ni-c/eve/documents/img/stepdown5v.jpg

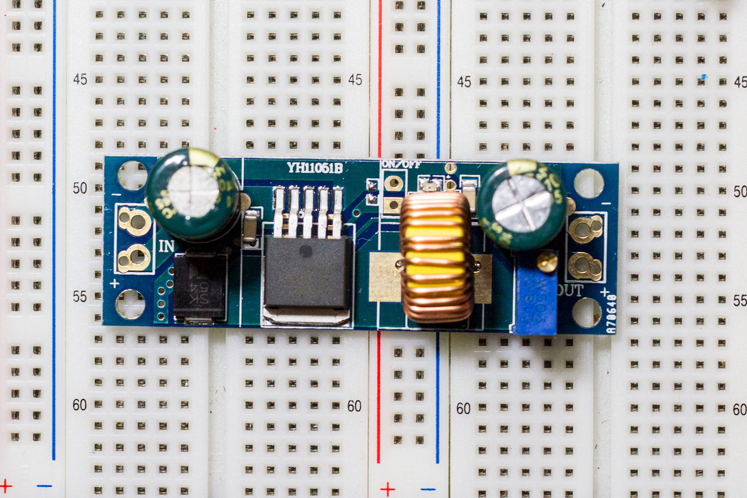
documents/img/stepdown5v.jpg
