ni-c/eve/documents/img/stepper.jpg

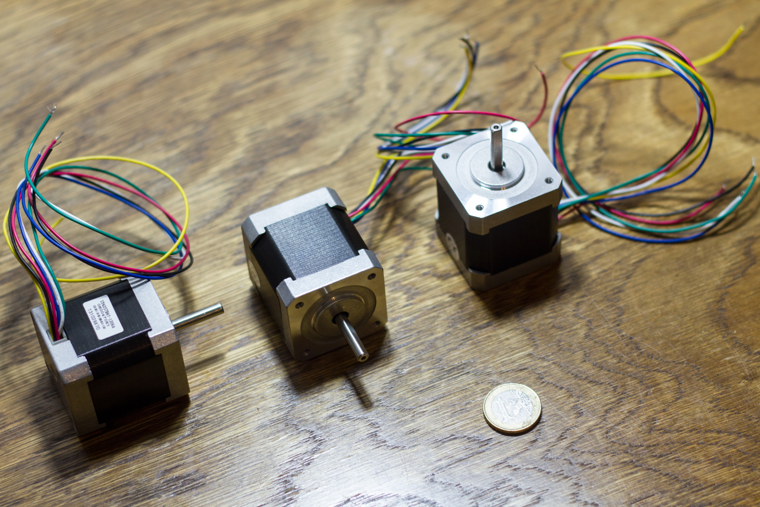
documents/img/stepper.jpg
