ni-c/eve/README.md

# eve

in action: https://vine.co/v/OreTuQMjX1V

### Autonomous omniwheel robot

Coded, compiled and flashed with a Raspberry PI

![eve] (https://raw.githubusercontent.com/ni-c/eve/master/documents/img/eve.001.jpg)

## Baseboard

### WIP

![Baseboard Schematics] (https://raw.githubusercontent.com/ni-c/eve/master/documents/img/baseboard.png)
