ni-c/eve/documents/img/baseboard.png

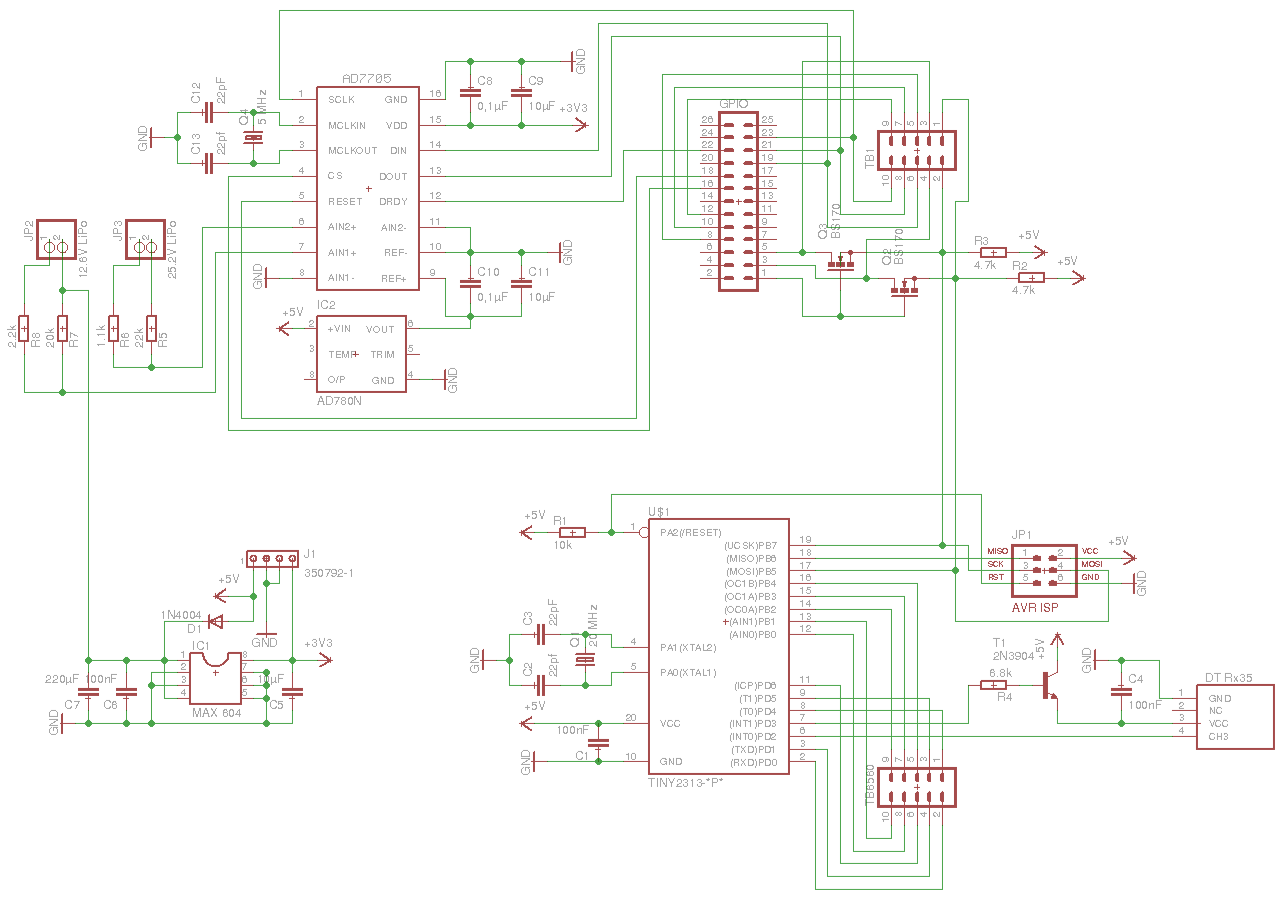
documents/img/baseboard.png
