ni-c/eve/documents/img/baseboard_bb.png

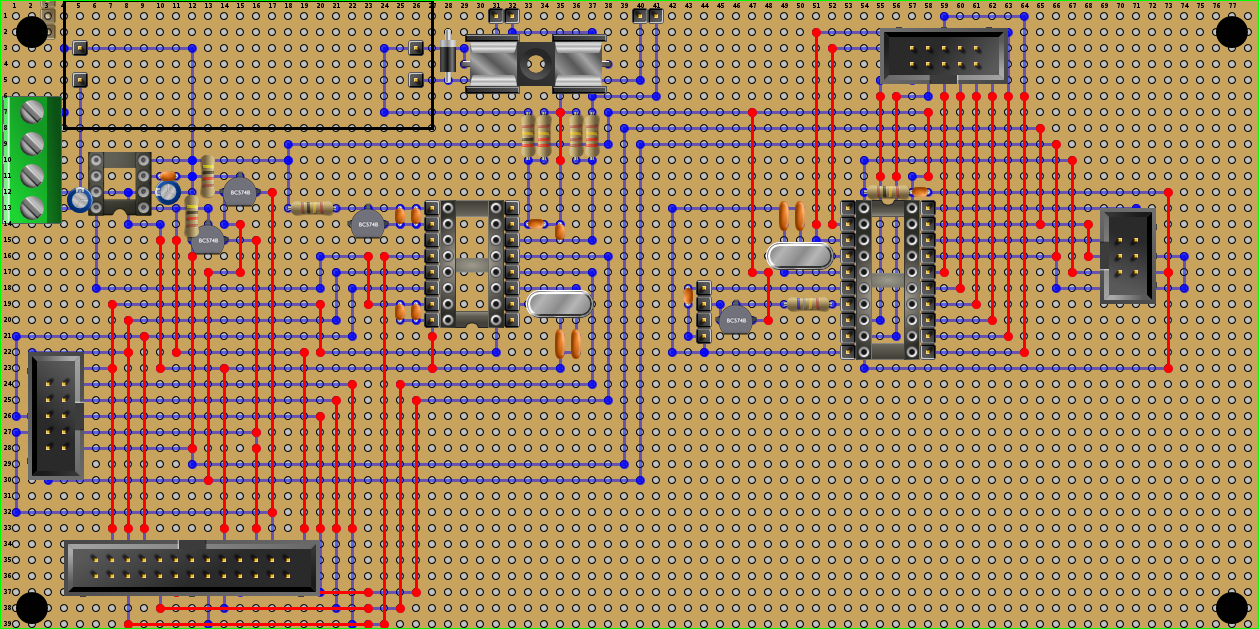
documents/img/baseboard_bb.png
