ni-c/eve/documents/img/baseboard_bb_back.png

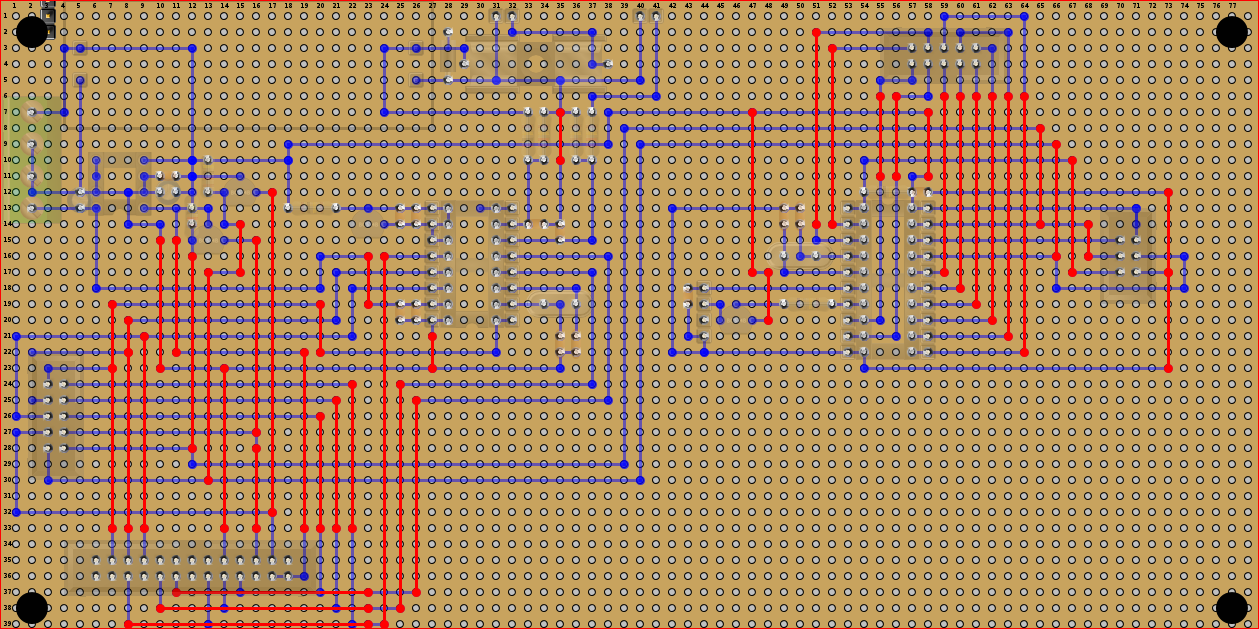
documents/img/baseboard_bb_back.png
