ni-c/eve/documents/img/eve.001.jpg

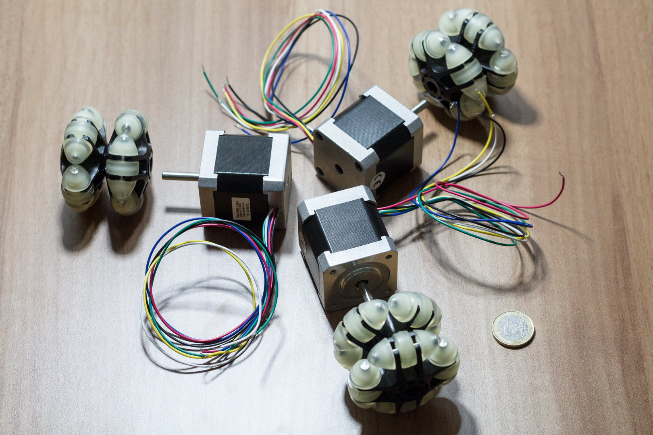
documents/img/eve.001.jpg
