ni-c/eve/documents/img/omniwheels.jpg

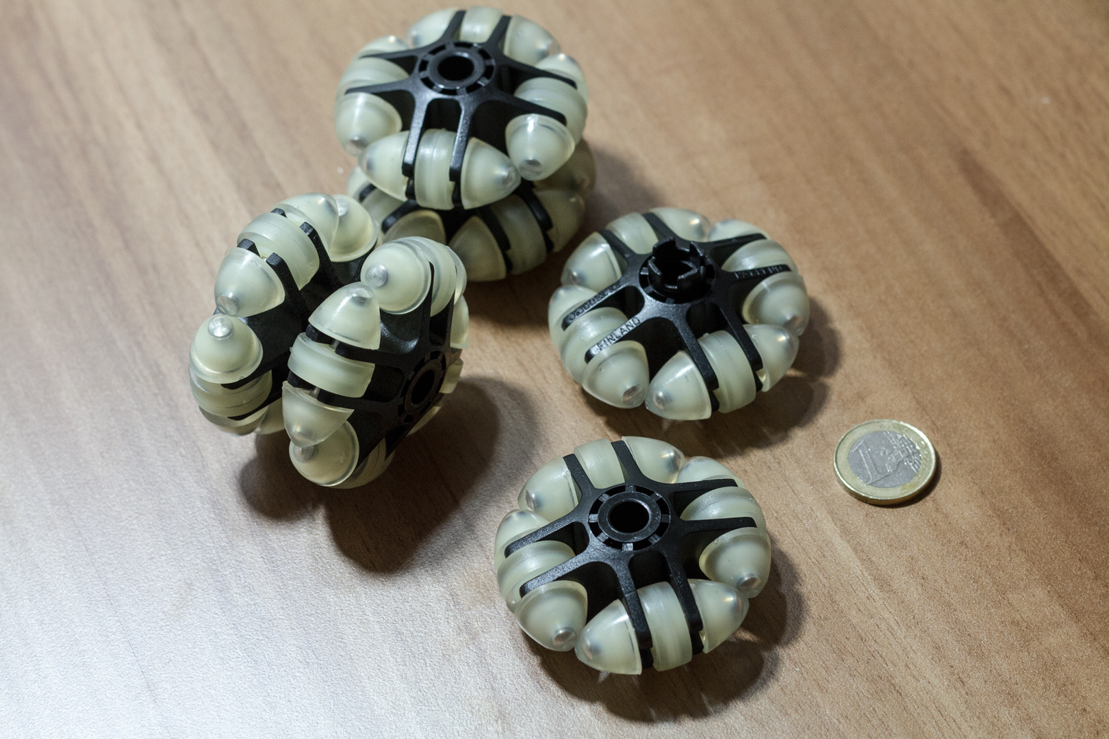
documents/img/omniwheels.jpg
