ni-c/eve/pi/client/img/motors.png

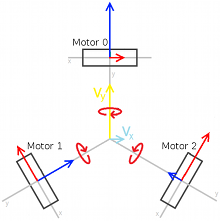
pi/client/img/motors.png
