ni-c/eve/documents/schematics/baseboard.sch

## EAGLE design documents/schematics/baseboard.sch (2014-02-16)

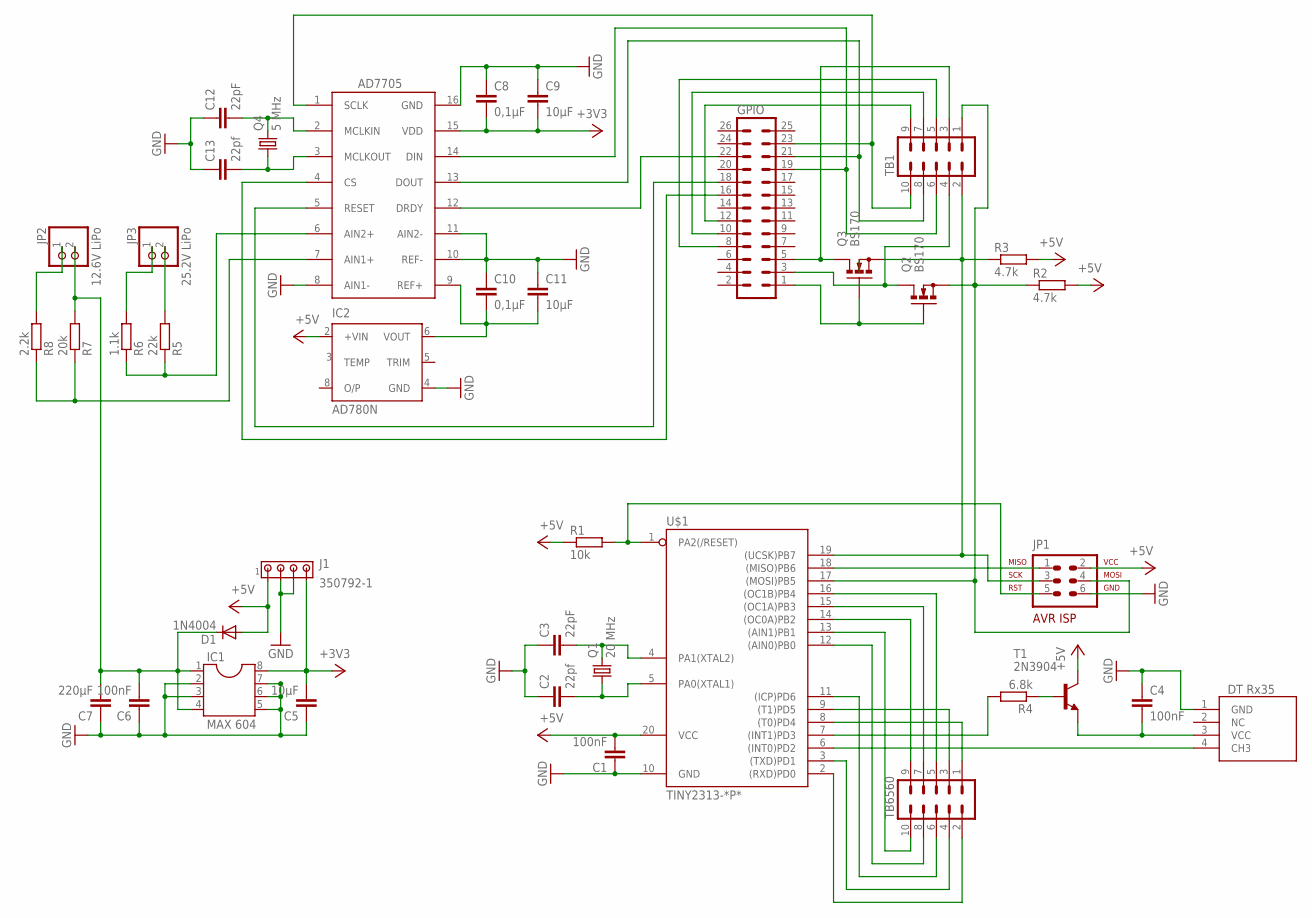
[picture p9: schematic baseboard.sch]

Parts:
C1, C4, C6: 100nF; C2.5-2
C2, C13: 22pf; C2.5-2
C3, C12: 22pF; C2.5-2
C5, C9, C11: 10µF; C2.5-2
C7: 220µF; C2.5-2
C8, C10: 0,1µF; C2.5-2
D1: 1N4004; DO41-10
GPIO: ML26
IC1: MAX 604; DIL08
IC2: AD780N; DIL08
J1: 350792-1
JP1: AVR-ISP-6VERT; AVR-ISP-6
JP2: 12.6V LiPo; 1X02
JP3: 25.2V LiPo; 1X02
Q1: 20 MHz; HC49/S
Q2, Q3: BS170; SOT54E
Q4: 5 MHz; HC49/S
R1: 10k; 0207/2V
R2, R3: 4.7k; 0207/2V
R4: 6.8k; 0207/12
R5: 22k; 0207/2V
R6: 1.1k; 0207/2V
R7: 20k; 0207/2V
R8: 2.2k; 0207/2V
T1: 2N3904; TO92
TB1, TB6560: ML10
U$1: TINY2313-*P*; DIL20
U$2: DTRX35
U$3: AD7705; AD7705BNC

Connections:
+3V3: C5.2, C8.2, C9.2, IC1.8, J1.4, U$3.15 (VDD)
+5V: C1.2, D1.A, IC2.2 (+VIN), J1.1, JP1.2, R1.1, R2.2, R3.2, T1.1 (C), U$1.20 (VCC)
GND: C1.1, C2.1, C3.1, C4.1, C5.1, C6.1, C7.1, C8.1, C9.1, C10.1, C11.1, C12.1, C13.1, IC1.2, IC1.3, IC1.5, IC1.6, IC1.7, IC2.4 (GND), J1.2, J1.3, JP1.6, U$1.10 (GND), U$2.1 (GND), U$3.8 (AIN1-), U$3.10 (REF-), U$3.11 (AIN2-), U$3.16 (GND)
unnamed: JP1.1, U$1.18 ((MISO)PB6)
unnamed: GPIO.5, Q3.D, TB1.3
unnamed: GPIO.3, Q2.D, TB1.4
unnamed: GPIO.1, Q2.G, Q3.G
unnamed: TB6560.1, U$1.8 ((T0)PD4)
unnamed: TB6560.3, U$1.9 ((T1)PD5)
unnamed: TB6560.5, U$1.16 ((OC1B)PB4)
unnamed: TB6560.7, U$1.15 ((OC1A)PB3)
unnamed: TB6560.9, U$1.14 ((OC0A)PB2)
unnamed: TB6560.10, U$1.13 ((AIN1)PB1)
unnamed: TB6560.8, U$1.12 ((AIN0)PB0)
unnamed: TB6560.6, U$1.11 ((ICP)PD6)
unnamed: TB6560.4, U$1.3 ((TXD)PD1)
unnamed: R4.1, T1.2 (B)
unnamed: JP1.4, Q2.S, R2.1, TB1.1, U$1.17 ((MOSI)PB5)
unnamed: C4.2, T1.3 (E), U$2.3 (VCC)
unnamed: R4.2, U$1.7 ((INT1)PD3)
unnamed: C3.2, Q1.2, U$1.4 (PA1(XTAL2))
unnamed: C2.2, Q1.1, U$1.5 (PA0(XTAL1))
unnamed: JP1.5, R1.2, U$1.1 (PA2(/RESET))
unnamed: U$1.6 ((INT0)PD2), U$2.4 (CH3)
unnamed: TB6560.2, U$1.2 ((RXD)PD0)
unnamed: GPIO.12, TB1.9
unnamed: GPIO.10, TB1.7
unnamed: GPIO.8, TB1.5
unnamed: GPIO.23, TB1.10, U$3.1 (SCLK)
unnamed: JP1.3, Q3.S, R3.1, TB1.2, U$1.19 ((UCSK)PB7)
unnamed: GPIO.21, TB1.8, U$3.13 (DOUT)
unnamed: GPIO.19, TB1.6, U$3.14 (DIN)
unnamed: C10.2, C11.2, IC2.6 (VOUT), U$3.9 (REF+)
unnamed: C6.2, C7.2, D1.C, IC1.1, IC1.4, JP2.2, R7.2
unnamed: JP3.1, R6.2
unnamed: JP2.1, R8.2
unnamed: C12.2, Q4.2, U$3.2 (MCLKIN)
unnamed: C13.2, Q4.1, U$3.3 (MCLKOUT)
unnamed: R5.1, R6.1, U$3.6 (AIN2+)
unnamed: R7.1, R8.1, U$3.7 (AIN1+)
unnamed: JP3.2, R5.2
unnamed: GPIO.22, U$3.12 (DRDY)
unnamed: GPIO.16, U$3.4 (CS)
unnamed: GPIO.18, U$3.5 (RESET)
