ni-c/eve/documents/schematics/tiny2313.sch

## EAGLE design documents/schematics/tiny2313.sch (2014-01-26)

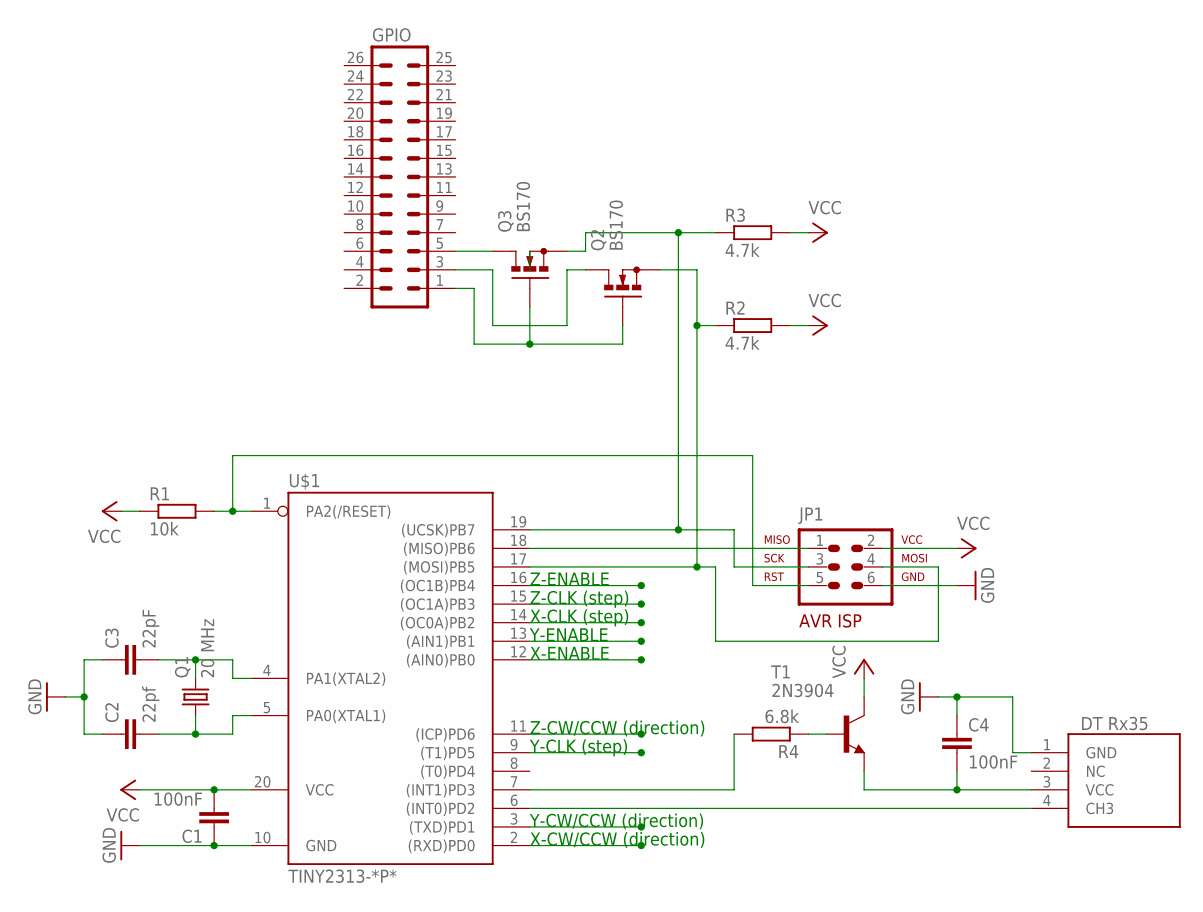
[picture p10: schematic tiny2313.sch]

Parts:
C1, C4: 100nF; C2.5-2
C2: 22pf; C2.5-2
C3: 22pF; C2.5-2
GPIO: ML26
JP1: AVR-ISP-6VERT; AVR-ISP-6
Q1: 20 MHz; HC49/S
Q2, Q3: BS170; SOT54E
R1: 10k; 0207/2V
R2, R3: 4.7k; 0207/2V
R4: 6.8k; 0207/12
T1: 2N3904; TO92
U$1: TINY2313-*P*; DIL20
U$2: DTRX35

Connections:
GND: C1.1, C2.1, C3.1, C4.1, JP1.6, U$1.10 (GND), U$2.1 (GND)
unnamed: JP1.1, U$1.18 ((MISO)PB6)
unnamed: GPIO.5, Q3.D
unnamed: GPIO.3, Q2.D
unnamed: GPIO.1, Q2.G, Q3.G
unnamed: R4.1, T1.2 (B)
unnamed: JP1.4, Q2.S, R2.1, U$1.17 ((MOSI)PB5)
unnamed: C4.2, T1.3 (E), U$2.3 (VCC)
unnamed: R4.2, U$1.7 ((INT1)PD3)
unnamed: C3.2, Q1.2, U$1.4 (PA1(XTAL2))
unnamed: C2.2, Q1.1, U$1.5 (PA0(XTAL1))
unnamed: JP1.5, R1.2, U$1.1 (PA2(/RESET))
unnamed: U$1.6 ((INT0)PD2), U$2.4 (CH3)
unnamed: JP1.3, Q3.S, R3.1, U$1.19 ((UCSK)PB7)
VCC: C1.2, JP1.2, R1.1, R2.2, R3.2, T1.1 (C), U$1.20 (VCC)

Notes on the sheet:
X-CLK (step)
Y-CLK (step)
Z-CLK (step)
X-ENABLE
Y-ENABLE
Z-ENABLE
X-CW/CCW (direction)
Y-CW/CCW (direction)
Z-CW/CCW (direction)
