ni-c/eve/baseboard/include/i2cslave.h

/*
 *
 * Name: USI TWI Slave driver - I2C/TWI-EEPROM
 * Version: 1.3  - Stable
 * autor: Martin Junghans	jtronics@gmx.de
 * page: www.jtronics.de
 * License: GNU General Public License
 *
 * Created from Atmel source files for Application Note AVR312:
 * Using the USI Module as an I2C slave like an I2C-EEPROM.
 *
 * LICENSE: Copyright (C) 2010 Marin Junghans
 *
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
 * 16.11.2010 - reworked by Markus Schatzl
 *
 * 23.01.2014 - reworked by Willi Thiel
 */

#ifndef _I2CSLAVE_H_
#define _I2CSLAVE_H_

#include "main.h"

volatile uint8_t i2c_buffer[I2C_BUFFER_SIZE]; /*!< I2C buffer */
volatile uint8_t buffer_adr; /*!< Virtual buffer address register */

/**
 * Initialize slave
 *
 * @param address The address of the I2C slave device
 */
void i2c_init(uint8_t address);

/**
 * Returns 1 if new data was received
 *
 * @return 1 if new data was received
 */
uint8_t i2c_received_data(void);

#if 	(I2C_BUFFER_SIZE > 254)
#error Buffer to big! 254 bytes max.

#elif 	(I2C_BUFFER_SIZE < 2)
#error Buffer to small! 2 bytes min.
#endif

#if     defined( __AVR_ATtiny2313__ )
#define DDR_USI             DDRB
#define PORT_USI            PORTB
#define PIN_USI             PINB
#define PORT_USI_SDA        PB5
#define PORT_USI_SCL        PB7
#define PIN_USI_SDA         PINB5
#define PIN_USI_SCL         PINB7
#define USI_START_COND_INT  USISIF
#define USI_START_VECTOR    USI_START_vect
#define USI_OVERFLOW_VECTOR USI_OVERFLOW_vect

#elif   defined( __AVR_ATtiny24A__ ) | \
        defined( __AVR_ATtiny44A__ ) | \
        defined( __AVR_ATtiny24__ )  | \
        defined( __AVR_ATtiny44__ )  | \
        defined( __AVR_ATtiny84__ )
#define DDR_USI             DDRA
#define PORT_USI            PORTA
#define PIN_USI             PINA
#define PORT_USI_SDA        PA6
#define PORT_USI_SCL        PA4
#define PIN_USI_SDA         PINA6
#define PIN_USI_SCL         PINA4
#define USI_START_COND_INT  USISIF
#define USI_START_VECTOR    USI_STR_vect
#define USI_OVERFLOW_VECTOR USI_OVF_vect

#elif   defined( __AVR_ATtiny25__ ) | \
        defined( __AVR_ATtiny45__ ) | \
        defined( __AVR_ATtiny85__ )
#define DDR_USI             DDRB
#define PORT_USI            PORTB
#define PIN_USI             PINB
#define PORT_USI_SDA        PB0
#define PORT_USI_SCL        PB2
#define PIN_USI_SDA         PINB0
#define PIN_USI_SCL         PINB2
#define USI_START_COND_INT  USISIF
#define USI_START_VECTOR    USI_START_vect
#define USI_OVERFLOW_VECTOR USI_OVF_vect

#elif   defined( __AVR_ATtiny26__ )
#define DDR_USI             DDRB
#define PORT_USI            PORTB
#define PIN_USI             PINB
#define PORT_USI_SDA        PB0
#define PORT_USI_SCL        PB2
#define PIN_USI_SDA         PINB0
#define PIN_USI_SCL         PINB2
#define USI_START_COND_INT  USISIF
#define USI_START_VECTOR    USI_STRT_vect
#define USI_OVERFLOW_VECTOR USI_OVF_vect

#elif   defined( __AVR_ATtiny261__ ) | \
        defined( __AVR_ATtiny461__ ) | \
        defined( __AVR_ATtiny861__ )
#define DDR_USI             DDRB
#define PORT_USI            PORTB
#define PIN_USI             PINB
#define PORT_USI_SDA        PB0
#define PORT_USI_SCL        PB2
#define PIN_USI_SDA         PINB0
#define PIN_USI_SCL         PINB2
#define USI_START_COND_INT  USISIF
#define USI_START_VECTOR    USI_START_vect
#define USI_OVERFLOW_VECTOR USI_OVF_vect

#elif   defined( __AVR_ATmega165__ ) | \
        defined( __AVR_ATmega325__ ) | \
        defined( __AVR_ATmega3250__ ) | \
        defined( __AVR_ATmega645__ ) | \
        defined( __AVR_ATmega6450__ ) | \
        defined( __AVR_ATmega329__ ) | \
        defined( __AVR_ATmega3290__ )
#define DDR_USI             DDRE
#define PORT_USI            PORTE
#define PIN_USI             PINE
#define PORT_USI_SDA        PE5
#define PORT_USI_SCL        PE4
#define PIN_USI_SDA         PINE5
#define PIN_USI_SCL         PINE4
#define USI_START_COND_INT  USISIF
#define USI_START_VECTOR    USI_START_vect
#define USI_OVERFLOW_VECTOR USI_OVERFLOW_vect

#elif   defined( __AVR_ATmega169__ )
#define DDR_USI             DDRE
#define PORT_USI            PORTE
#define PIN_USI             PINE
#define PORT_USI_SDA        PE5
#define PORT_USI_SCL        PE4
#define PIN_USI_SDA         PINE5
#define PIN_USI_SCL         PINE4
#define USI_START_COND_INT  USISIF
#define USI_START_VECTOR    USI_START_vect
#define USI_OVERFLOW_VECTOR USI_OVERFLOW_vect

#elif   defined( __AVR_ATtiny24__ ) | \
        defined( __AVR_ATtiny44__ ) | \
        defined( __AVR_ATtiny84__ )
#define DDR_USI             DDRA
#define PORT_USI            PORTA
#define PIN_USI             PINA
#define PORT_USI_SDA        PA6
#define PORT_USI_SCL        PA4
#define PIN_USI_SDA         PINA6
#define PIN_USI_SCL         PINA4
#define USI_START_COND_INT  USISIF
#define USI_START_VECTOR    USI_STR_vect
#define USI_OVERFLOW_VECTOR USI_OVF_vect

#else
#error "no USI-Slave definition for MCU available"

#endif

#endif  // ifndef _I2CSLAVE_H_
