ni-c/eve/pi/webserver.py

#!/usr/bin/python

import json, os
from BaseHTTPServer import BaseHTTPRequestHandler

class JsonApi(BaseHTTPRequestHandler):
    
    def do_POST(self):
        if self.path == '/data.json':
            try:
                content_len = int(self.headers.getheader('content-length'))
                post_body = self.rfile.read(content_len)
                post_data = json.loads(post_body)
                try:
                    if post_data['enabled']['rc']:
                        self.server.bb.enableRC()
                    else:
                        self.server.bb.disableRC()
                except:
                    pass
                try:
                    if post_data['enabled']['motor']:
                        self.server.bb.enableMotor()
                    else:
                        self.server.bb.disableMotor()
                except:
                    pass
                self.send_response(200)
            except:
                self.send_error(400, "Bad Request")
        elif self.path == '/control.json':
            try:
                content_len = int(self.headers.getheader('content-length'))
                post_body = self.rfile.read(content_len)
                post_data = json.loads(post_body)
                self.server.bb.setMotorSteps(0, post_data['motor0']['steps']).setMotorSpeed(0, post_data['motor0']['speed']).setMotorDirection(0, post_data['motor0']['direction']);
                self.server.bb.setMotorSteps(1, post_data['motor1']['steps']).setMotorSpeed(1, post_data['motor1']['speed']).setMotorDirection(1, post_data['motor1']['direction']);
                self.server.bb.setMotorSteps(2, post_data['motor2']['steps']).setMotorSpeed(2, post_data['motor2']['speed']).setMotorDirection(2, post_data['motor2']['direction']);
            except:
                self.send_error(400, "Bad Request")
        elif self.path == '/shutdown.json':
            os.system("sudo shutdown -h now")
        else:
            self.send_error(404, "Not Found")
            
    def do_GET(self):
        if self.path == '/data.json':
            self.send_response(200)
            self.send_header('Content-type', 'application/json')
            self.end_headers()
            result = json.dumps({'rc': { 
                                  'channel0': self.server.bb.getRCChannel(0),
                                  'channel1': self.server.bb.getRCChannel(1),
                                  'channel2': self.server.bb.getRCChannel(2),
                                  'channel3': self.server.bb.getRCChannel(3)
                                }, 'motors': {
                                  'motor0': {
                                    'steps': self.server.bb.getMotorSteps(0),
                                    'speed': self.server.bb.getMotorSpeed(0),
                                    'direction': self.server.bb.getMotorDirection(0)
                                  },
                                  'motor1': {
                                    'steps': self.server.bb.getMotorSteps(1),
                                    'speed': self.server.bb.getMotorSpeed(1),
                                    'direction': self.server.bb.getMotorDirection(1)
                                  },
                                  'motor2': {
                                    'steps': self.server.bb.getMotorSteps(2),
                                    'speed': self.server.bb.getMotorSpeed(2),
                                    'direction': self.server.bb.getMotorDirection(2)
                                  }
                                }, 'enabled': {
                                    'rc': self.server.bb.isRCEnabled(),
                                    'motor': self.server.bb.isMotorEnabled()
                                }, 'voltage': {
                                    'channel0': self.server.bb.getVoltage(0)
                                }}, sort_keys=True)
            self.wfile.write(result)
        else:
            try:
                path = self.path.replace('..', '')
                if path == '/':
                    path = '/index.html'
                f = open(os.curdir + os.sep + 'client' + path)
                self.send_response(200)
                if path.endswith('.html'):
                    self.send_header('Content-type', 'text/html')
                elif path.endswith('.js') or path.endswith('.js.map'):
                    self.send_header('Content-type', 'application/javascript')
                elif path.endswith('.css'):
                    self.send_header('Content-type', 'text/css')
                elif path.endswith('.png'):
                    self.send_header('Content-type', 'image/png')
                else:
                    self.send_error(404, "Not Found")
                self.end_headers()
                self.wfile.write(f.read())
                f.close()
            except:
                self.send_error(404, "Not Found")
                
    def log_message(self, format, *args):
        return
