ni-c/eve/baseboard/main.h

/**
 * eve (https://github.com/ni-c/eve)
 *
 * @file    main.h
 * @brief   Main program
 * @author  Willi Thiel (ni-c@ni-c.de)
 * @date    Jan 25, 2014
*/
#ifndef MAIN_H_
#define MAIN_H_

#ifndef F_CPU
#define F_CPU 20000000UL /*!< Set CPU clock */
#endif

#define I2C_BUFFER_SIZE 32 /*!< Size of the I2C buffer 2..254 */

#endif
