ni-c/eve/(commit log)

2014-01-23 Sending 16-bit words over I2C
2014-01-24 Added RX library, datasheets and schematics
    [tiny2313.sch]
2014-01-25 RX12 receiver can now be en-/disabled via I2C
    [tiny2313.sch]
2014-01-25 Implemented stepper control
2014-01-26 Added BlackBoard schematics
    [tiny2313.sch]
2014-01-26 Baseboard getting bigger and bigger
    [baseboard.sch]
2014-01-26 Changed label of MAX 604
    [baseboard.sch]
2014-01-27 Baseboard alpha
    [baseboard.sch]
2014-01-27 Baseboard Bugfix
    [baseboard.sch]
2014-02-16 Updated schematics
    [baseboard.sch]
2014-02-16 Implemented motor direction
2014-02-20 Enhanced motor control
2014-11-23 Motorcontrol finally working
2014-11-23 Added en-/disable for motorcontrol
2014-11-25 Added shutdown button
2014-11-26 Optimized motor interrupt
2014-11-26 Added Motor En-/Disabled switch
